alexus2033/Alphabeat-Controller/Alphabeat-Controller-Schematic.pdf

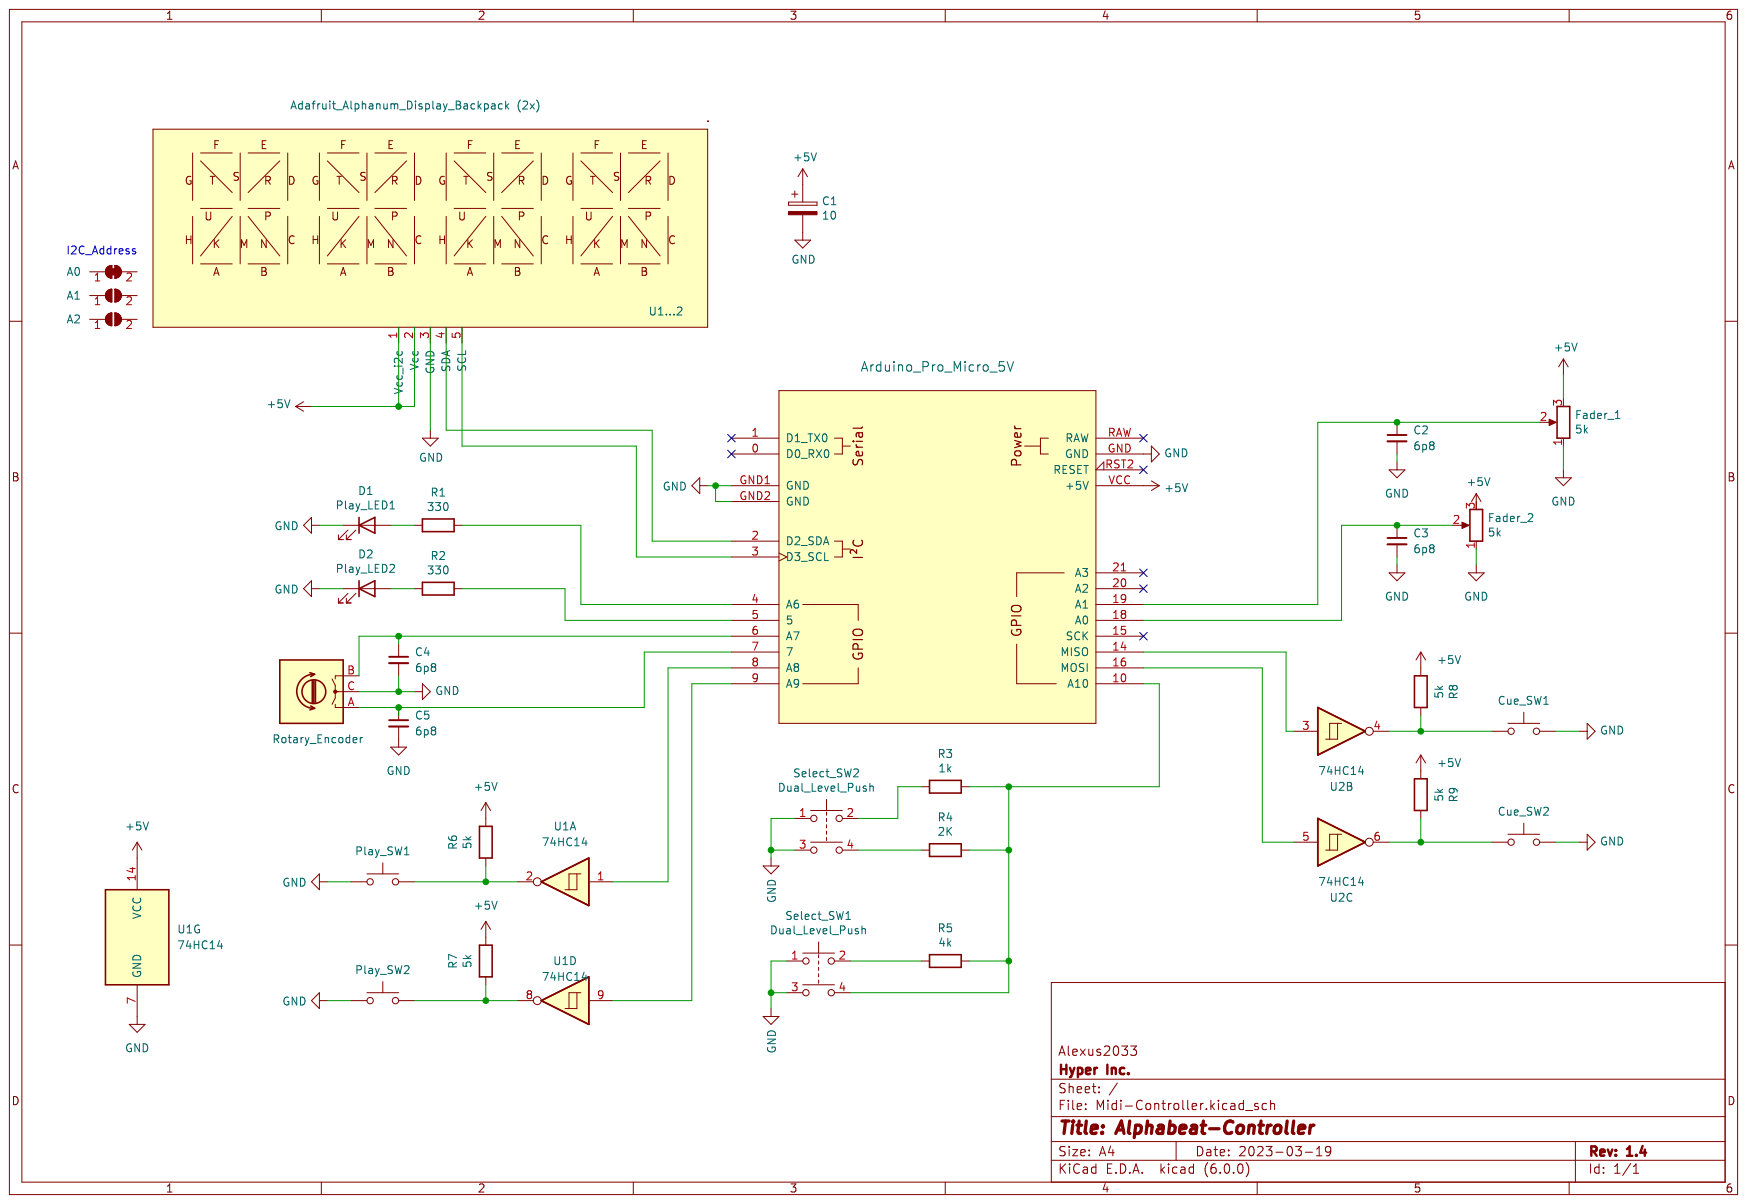
[picture p2: page 1]
