alexus2033/Alphabeat-Controller/(commit log)

2021-11-17 Arduino Files added
2021-11-20 rotary encoder added
2021-11-20 Exponentially weighted moving average filter added
2021-11-21 Cue Button added
2021-11-21 Timer removed
2021-11-21 KiCad Schematic added
2021-11-28 set timer for paused track
2021-11-28 Schematic update
2022-01-15 Kicad schematic update
2022-01-15 Cue-Button fixed
2022-01-29 Script to change Arduino Device Name
2022-02-27 Encoder BugFix
2023-03-19 INT6 interrupt disabled
    See https://github.com/misan/dcservo/issues/54
    [AlphaBeat_Midi_Control.ino]
2023-03-19 Capacitors added to schematic
2023-03-26 Inactivity timer fixed
2023-03-27 invert rotary encoder
